Gray-Stone/esp-miniarm/DC_servo_joint/DC_servo_joint.kicad_pcb

## KiCad design DC_servo_joint/DC_servo_joint.kicad_pcb (2025-08-28)

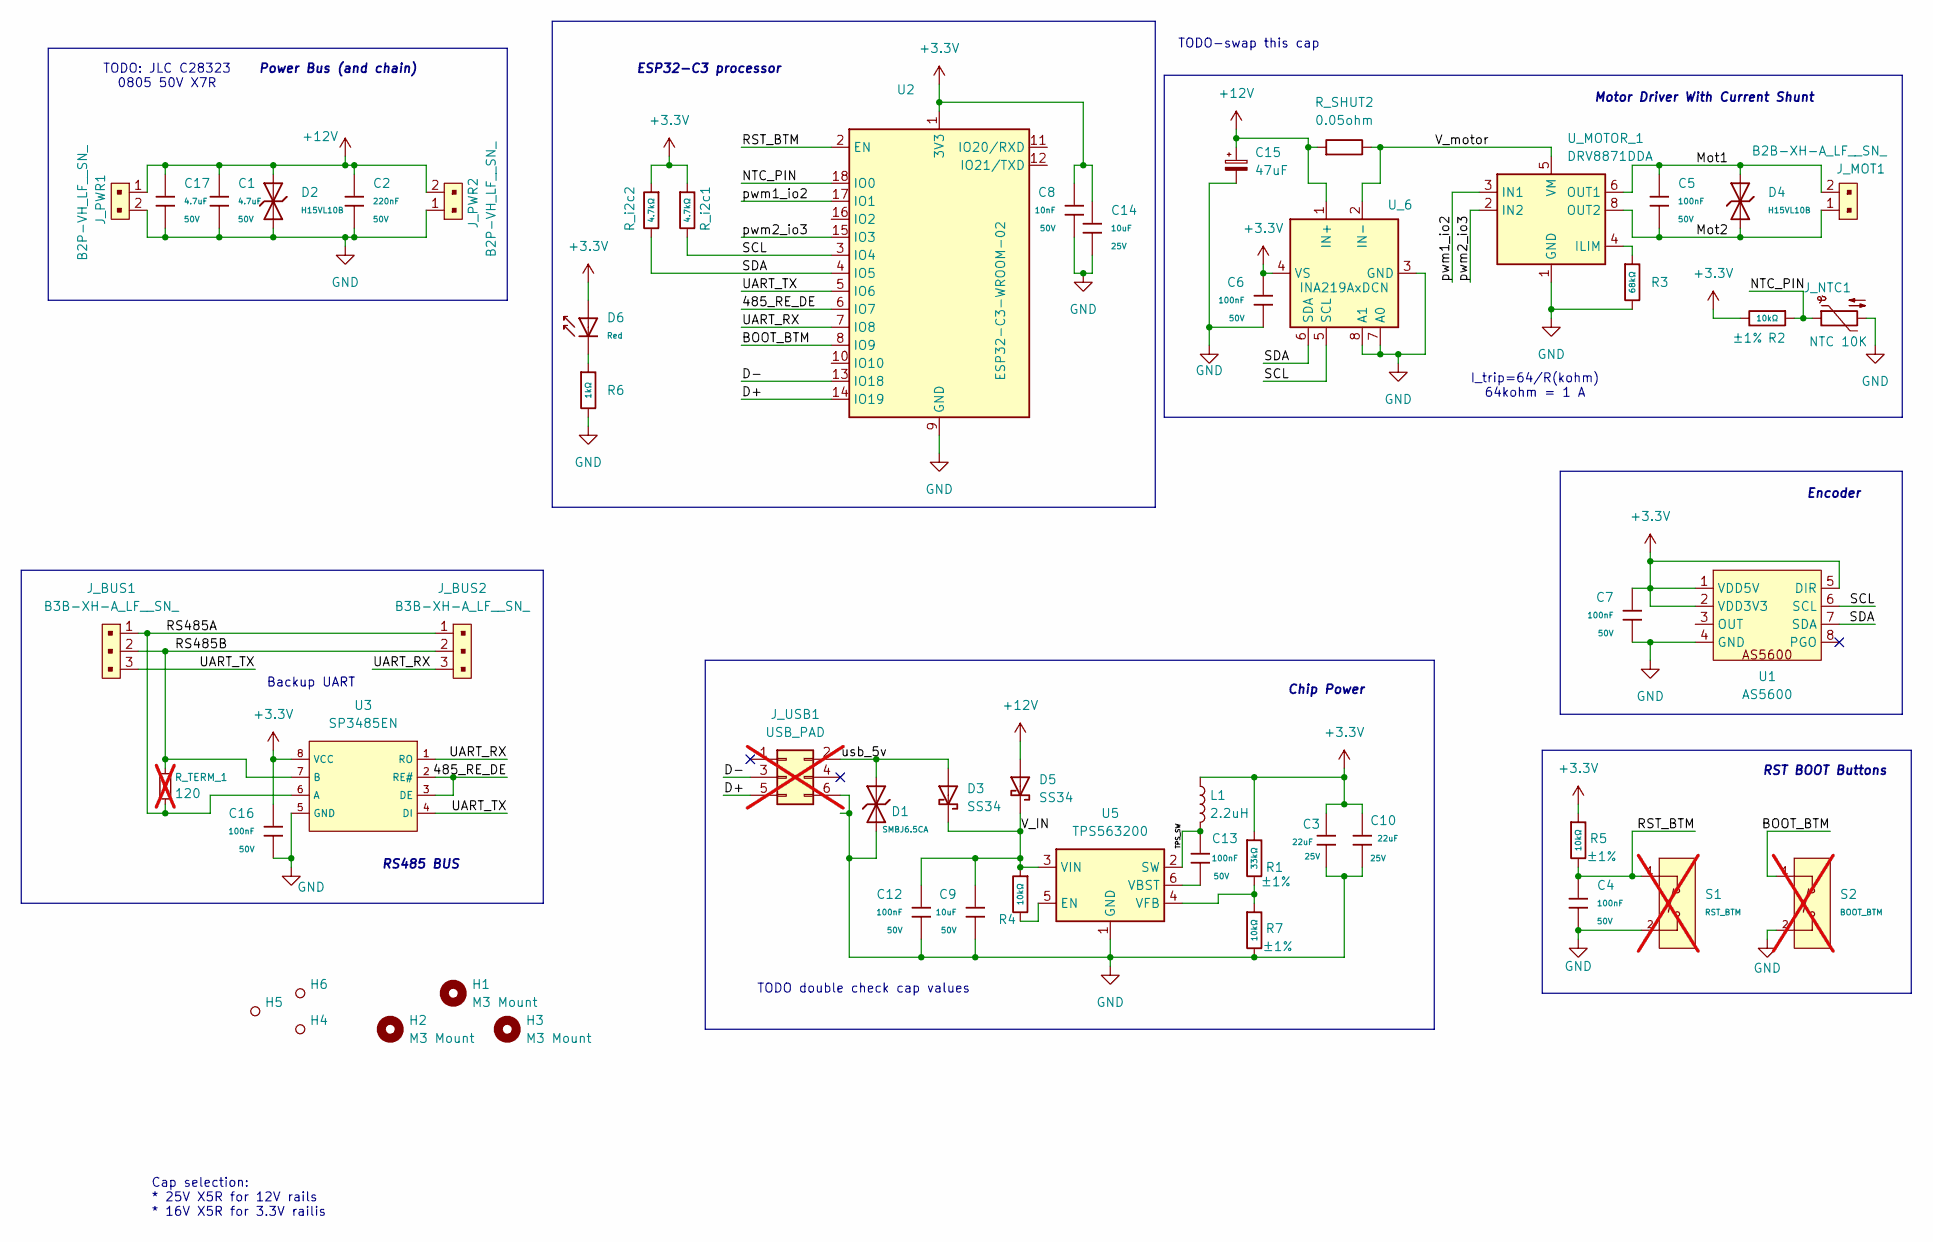
[picture p1: schematic DC_servo_joint.kicad_sch]

Parts:
C1, C17: 4.7uF; C_1206; Voltage Rated 50V; Tolerance ±10%; Part 1206B475K500NT; LCSC C29823
C2: 220nF; C_1206; Voltage Rated 50V; Tolerance ±10%; Part 1206B224K500NT; LCSC C1857
C3, C10: 22uF; C_1206; Voltage Rated 25V; Tolerance ±10%; Part CL31A226KAHNNNE; LCSC C12891
C4, C6, C7, C12, C13, C16: 100nF; C_0603; Voltage Rated 50V; Tolerance ±10%; Part CC0603KRX7R9BB104; LCSC C14663
C5: 100nF; C_1206; Voltage Rated 50V; Tolerance ±10%; Part CL31B104KBCNNNC; LCSC C24497
C8: 10nF; C_0603; Voltage Rated 50V; Tolerance ±10%; Part 0603B103K500NT; LCSC C57112
C9: 10uF; C_1206; Voltage Rated 50V; Tolerance ±10%; Part CL31A106KBHNNNE; LCSC C13585
C14: 10uF; C_0805; Voltage Rated 25V; Tolerance ±10%; Part CL21A106KAYNNNE; LCSC C15850
C15: 47uF; CP_Radial_D8.0mm_P3.50mm
D1: SMBJ6.5CA; D_SMB; Breakdown Voltage 7.22V; Part SMBJ6.5CA; LCSC C7420377
D2, D4: H15VL10B; D_DFN1006-2L; Part H15VL10B; LCSC C20615791
D3, D5: SS34; D_SMA; Forward Voltage (Vf@If) 550mV@3A; Reverse Voltage (Vr) 40V; Part SS34; LCSC C8678
D6: Red; D_0603; Part KT-0603R; LCSC C2286
H1, H2, H3: M3 Mount; MountingHole_3.2mm_M3_DIN965
H4, H5, H6: Hole_Tooling_JLCPCB
J_BUS1, J_BUS2: B3B-XH-A_LF__SN_; JST_XH_S3B-XH-A_1x03_P2.50mm_Horizontal; MPN B3B-XH-A(LF)(SN); Digi-Key_PN 455-2248-ND
J_MOT1: B2B-XH-A_LF__SN_; JST_XH_S2B-XH-A_1x02_P2.50mm_Horizontal; MPN B2B-XH-A(LF)(SN); Digi-Key_PN 455-2247-ND
J_NTC1: NTC 10K; JST_XH_S2B-XH-A_1x02_P2.50mm_Horizontal
J_PWR1, J_PWR2: B2P-VH_LF__SN_; JST_VH_S2P-VH_1x02_P3.96mm_Horizontal; MPN B2P-VH(LF)(SN); Digi-Key_PN 455-1639-ND
J_USB1: USB_PAD; PinSocket_2x03_P2.54mm_Vertical; not fitted
L1: 2.2uH; L_Vishay_IHLP-1616; JLC_PART C844973
R1: 33kΩ; R_0402; Overload Voltage (Max) 50V; Tolerance ±1%; Part 0402WGF3302TCE; LCSC C25779
R2, R5, R7: 10kΩ; R_0402; Overload Voltage (Max) 50V; Tolerance ±1%; Part 0402WGF1002TCE; LCSC C25744
R3: 68kΩ; R_0805; Overload Voltage (Max) 150V; Tolerance ±1%; Part 0805W8F6802T5E; LCSC C17801
R4: 10kΩ; R_0603; Overload Voltage (Max) 75V; Tolerance ±1%; Part 0603WAF1002T5E; LCSC C25804
R6: 1kΩ; R_0402; Overload Voltage (Max) 50V; Tolerance ±1%; Part 0402WGF1001TCE; LCSC C11702
R_SHUT2: 0.05ohm; 1206; JLC C7467249
R_TERM_1: 120; 0805; not fitted
R_i2c1, R_i2c2: 4.7kΩ; R_0402; Overload Voltage (Max) 50V; Tolerance ±1%; Part 0402WGF4701TCE; LCSC C25900
S1: RST_BTM; SW_TS-1088-AR02016; Voltage Rating (Dc) 12V; Part TS-1088-AR02016; LCSC C720477; not fitted
S2: BOOT_BTM; SW_TS-1088-AR02016; Voltage Rating (Dc) 12V; Part TS-1088-AR02016; LCSC C720477; not fitted
U1: AS5600; SOIC-8_3.9x4.9mm_P1.27mm; LCSC C499458
U2: ESP32-C3-WROOM-02; LCSC C2934560
U3: SP3485EN; SOIC-8_L5.0-W4.0-P1.27-LS6.0-BL; Supply Voltage 3.3V; Part SP3485EN-L/TR; LCSC C8963
U5: TPS563200; SOT-23-6; LCSC C97253
U_6: INA219AxDCN; SOT-23-8; LCSC C87469
U_MOTOR_1: DRV8871DDA; Texas_HTSOP-8-1EP_3.9x4.9mm_P1.27mm_EP2.95x4.9mm_Mask2.4x3.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; LCSC C75864

Connections:
+3.3V: C3.1, C6.1, C7.1, C8.1, C10.1, C14.1, C16.1, D6.2, L1.1, R1.1, R2.2, R5.1, R_i2c1.1, R_i2c2.1, U1.1 (VDD5V), U1.2 (VDD3V3), U1.5 (DIR), U2.1 (3V3), U3.8 (VCC), U_6.4 (VS)
+12V: C1.1, C2.1, C15.1, C17.1, D2.2, D5.2, J_PWR1.1, J_PWR2.2, R_SHUT2.2, U_6.1 (IN+)
/485_RE_DE: U2.6 (IO7), U3.2 (RE#), U3.3 (DE)
/BOOT_BTM: S2.1 (A), U2.8 (IO9)
/D+: J_USB1.5, U2.14 (IO19)
/D-: J_USB1.3, U2.13 (IO18)
/Mot1: C5.1, D4.2, J_MOT1.2, U_MOTOR_1.6 (OUT1)
/Mot2: C5.2, D4.1, J_MOT1.1, U_MOTOR_1.8 (OUT2)
/NTC_PIN: J_NTC1.1, R2.1, U2.18 (IO0)
/RS485A: J_BUS1.1, J_BUS2.1, R_TERM_1.2, U3.6 (A)
/RS485B: J_BUS1.2, J_BUS2.2, R_TERM_1.1, U3.7 (B)
/RST_BTM: C4.1, R5.2, S1.1 (A), U2.2 (EN)
/SCL: R_i2c1.2, U1.6 (SCL), U2.3 (IO4), U_6.5 (SCL)
/SDA: R_i2c2.2, U1.7 (SDA), U2.4 (IO5), U_6.6 (SDA)
/TPS_SW: C13.1, L1.2, U5.2 (SW)
/UART_RX: J_BUS2.3, U2.7 (IO8), U3.1 (RO)
/UART_TX: J_BUS1.3, U2.5 (IO6), U3.4 (DI)
/V_IN: C9.1, C12.1, D3.1, D5.1, R4.1, U5.3 (VIN)
/V_motor: R_SHUT2.1, U_6.2 (IN-), U_MOTOR_1.5 (VM)
/pwm1_io2: U2.17 (IO1), U_MOTOR_1.3 (IN1)
/pwm2_io3: U2.15 (IO3), U_MOTOR_1.2 (IN2)
/usb_5v: D1.2, D3.2, J_USB1.2
GND: C1.2, C2.2, C3.2, C4.2, C6.2, C7.2, C8.2, C9.2, C10.2, C12.2, C14.2, C15.2, C16.2, C17.2, D1.1, D2.1, J_NTC1.2, J_PWR1.2, J_PWR2.1, J_USB1.6, R3.2, R6.2, R7.2, S1.2 (B), S2.2 (B), U1.4 (GND), U2.9 (GND), U2.19 (GND), U3.5 (GND), U5.1 (GND), U_6.3 (GND), U_6.7 (A0), U_6.8 (A1), U_MOTOR_1.1 (GND), U_MOTOR_1.7 (GND), U_MOTOR_1.9 (GND)
unnamed: D6.1, R6.1
unnamed: R4.2, U5.5 (EN)
unnamed: C13.2, U5.6 (VBST)
unnamed: R1.2, R7.1, U5.4 (VFB)
unnamed: R3.1, U_MOTOR_1.4 (ILIM)

Notes on the sheet:
Power Bus (and chain)
RS485 BUS
TODO-swap this cap
ESP32-C3 processor
Motor Driver With Current Shunt
TODO double check cap values
TODO: JLC C28323 0805 50V X7R
Backup UART
Encoder
Chip Power
I_trip=64/R(kohm) 64kohm = 1 A
RST BOOT Buttons
Cap selection: * 25V X5R for 12V rails * 16V X5R for 3.3V railis

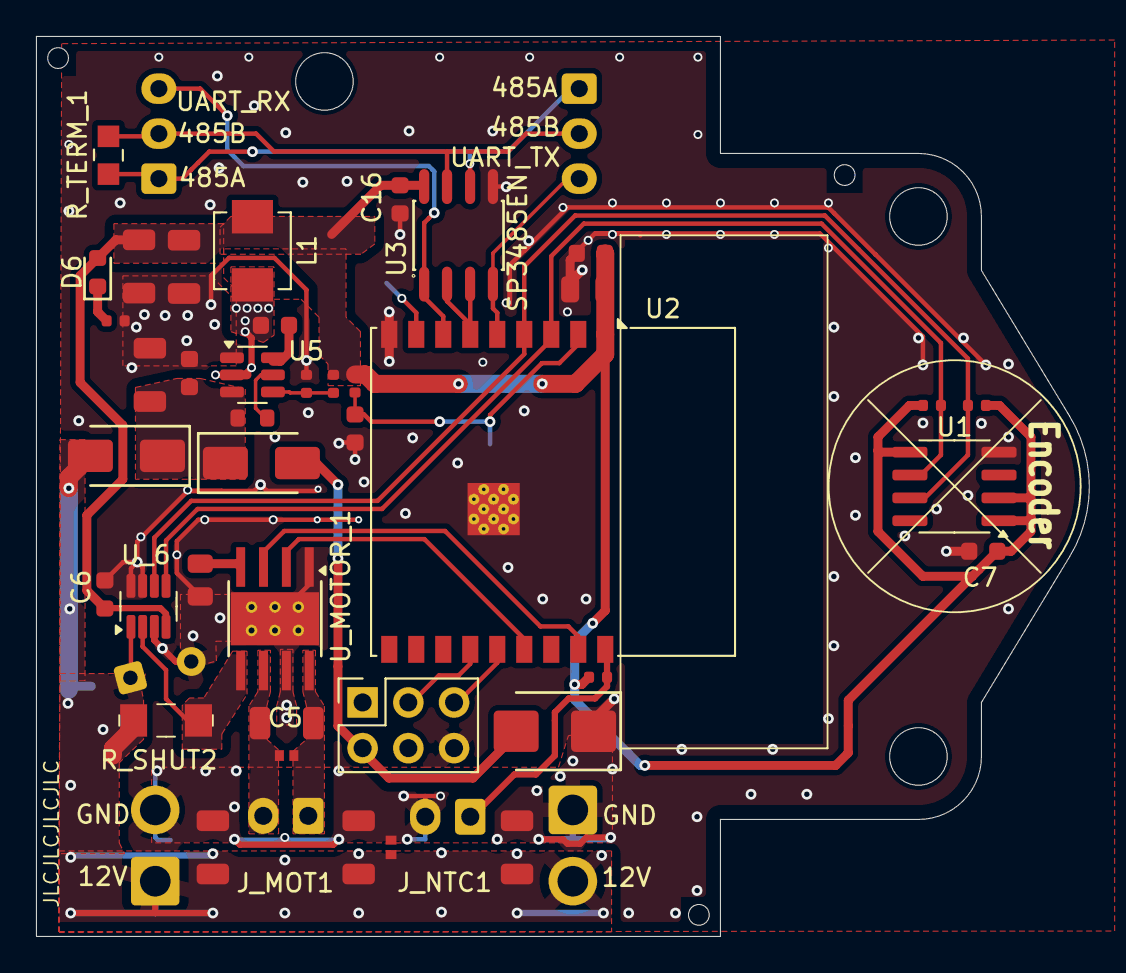
[picture p2: board DC_servo_joint.kicad_pcb from above]

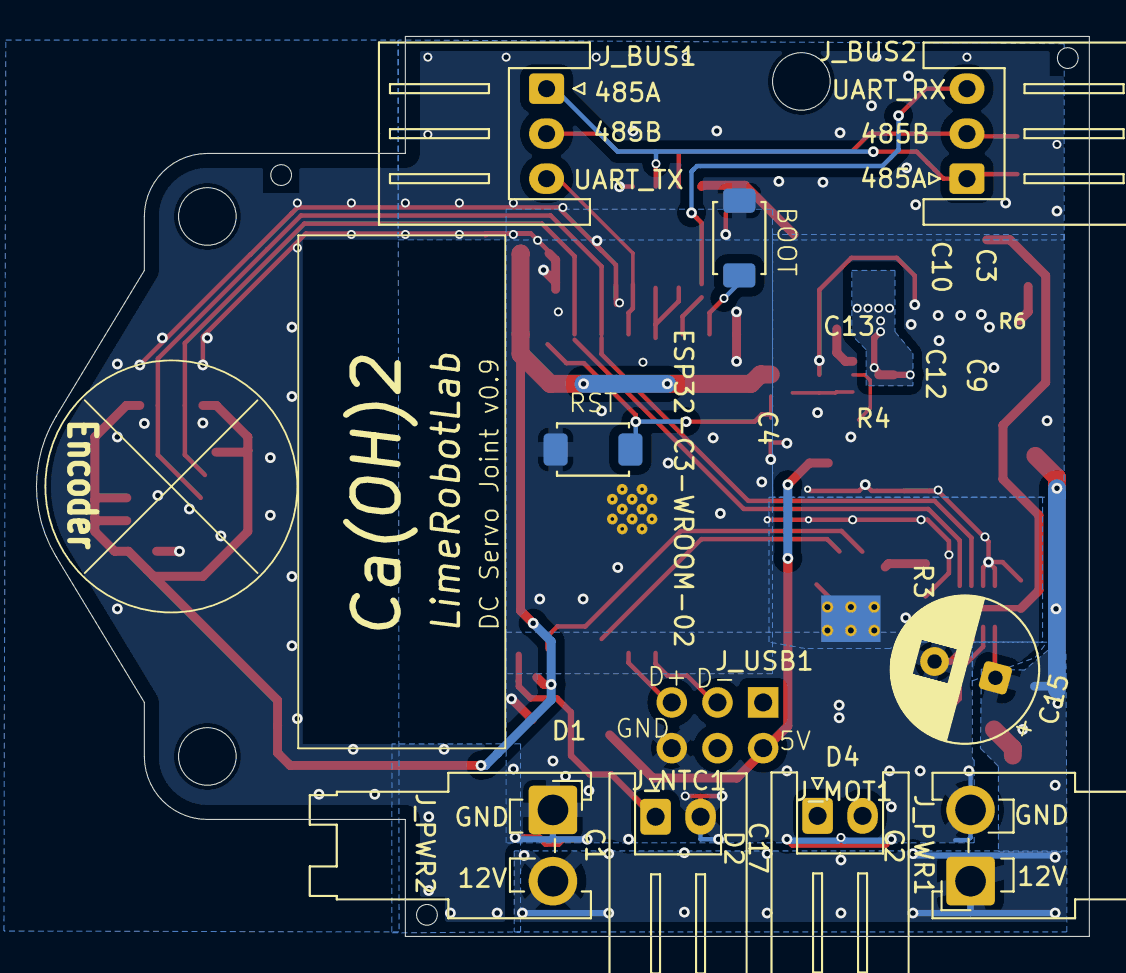
[picture p3: board DC_servo_joint.kicad_pcb from below]

Board: 2 copper layers, 58.5 x 50.0 mm, 55 parts (9 on the bottom side), 28 nets.
