Gray-Stone/esp-miniarm/(commit log)

2025-07-31 PID kinda working. with build and upload script.
2025-07-31 small clean up and more aggrasive PID values
2025-08-01 Made the single leg UART daisy chain loop worked
2025-08-03 Kicad first round of schematic design done
    [DC_servo_joint.kicad_pcb, DC_servo_joint.kicad_sch]
2025-08-03 Tried to play around with MT6701 encoder. nothing seems to work.
2025-08-03 New Power design with better switching chip.
    [DC_servo_joint.kicad_sch]
2025-08-04 Upgraded on power supply design. Simplifyed to no 5V stage, added tvs for protection.
    [DC_servo_joint.kicad_sch]
2025-08-04 Change to JST VH connector for power
    [gpt.kicad_sch]
2025-08-04 Made part selection for all caps and resistors.
    [DC_servo_joint.kicad_sch]
2025-08-05 Added a NTP to the system.
    [DC_servo_joint.kicad_sch]
2025-08-05 Update the usb header to 8 pins,
    [DC_servo_joint.kicad_pcb, DC_servo_joint.kicad_sch]
2025-08-05 Started Power source layout
    [DC_servo_joint.kicad_pcb, DC_servo_joint.kicad_sch]
2025-08-06 Most layout are in shape
    [DC_servo_joint.kicad_pcb, DC_servo_joint.kicad_sch]
2025-08-06 Finalize button placement
    [DC_servo_joint.kicad_pcb]
2025-08-07 Finalized Board outline. Fixed I2C signls. Roughtly figured out all compoent's location Still missing 3.3V stuff to be fixed
    [DC_servo_joint.kicad_pcb]
2025-08-07 Fixed missing tarce, added in some skilscreen fix
    [DC_servo_joint.kicad_pcb, DC_servo_joint.kicad_sch]
2025-08-07 add Kicad ignore
2025-08-07 Fix the 3.3V power layout
    [DC_servo_joint.kicad_pcb, DC_servo_joint.kicad_sch]
2025-08-08 Update Big cap selection. Better layout of power trace. Update silk screen. Fix lots of DRC vialation.
    [DC_servo_joint.kicad_pcb, DC_servo_joint.kicad_sch]
2025-08-08 Add personal Mark to the silkscreen
    [DC_servo_joint.kicad_pcb]
2025-08-08 Fixed the via size issue. Replace the INA219 with proper part
    [DC_servo_joint.kicad_pcb, DC_servo_joint.kicad_sch]
2025-08-08 Updated the proper value for INA219AxD and did part selection on JLC plugin
    [DC_servo_joint.kicad_pcb, DC_servo_joint.kicad_sch]
2025-08-08 Generated first trial of production file. Also added 2 rotations to parts.
    [BOM-DC_servo_joint.csv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]
2025-08-09 Add silkscreen in for usb header, Re generated production file
    [BOM-DC_servo_joint.csv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]
2025-08-09 Move GPIO2 to 3, Clean up I2C trace under encoder.
    [DC_servo_joint.kicad_pcb, DC_servo_joint.kicad_sch, positions.csv]
2025-08-28 Save the final production run of the circuit. mistake on AS5600 pinout
    [BOM-DC_servo_joint.csv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]
2025-09-08 Mark out the error on the DC servo joint PCB
    [DC_servo_joint.kicad_sch]
